Teknoid303/HyperDrive/(threads)

Thread 1 (2021-12-15):

shorted my nano? overcurrent?

GemacFPV, 2021-12-15:
Hey,
I builded the hyperdrive with 5 strands. The signal wire of the 5 strips are in parallel to one nano. I put a 550 ohm resistor between the strips and the nano.
I think the setup worked for like 2-3 hours, but then no leds lighting up.
I disconnected everything and reconnected, but no leds are lighting up.
I reuploaded the code and change the input pin. Nothing.
I tested it with an other strip and it worked. Back to the first strip nothing.
At the end I put the output pin directly to the strips and they light up, but the nano got incredible and i disconnected everything.
Now the nano gets hot after i plug it in the usb. short ?
What you suggest I should do ? Even higher resistor?
I don't want to use more nanos, because it would destroy the effect...
