Teknoid303/HyperDrive/(commit log)

2020-02-14 Add files via upload
    Real circuit pic
2020-03-06 A few updates to power and leds
